kpocza/MachineMeter/docs/Eagle/CircoController.sch

## EAGLE design docs/Eagle/CircoController.sch (2020-05-09)

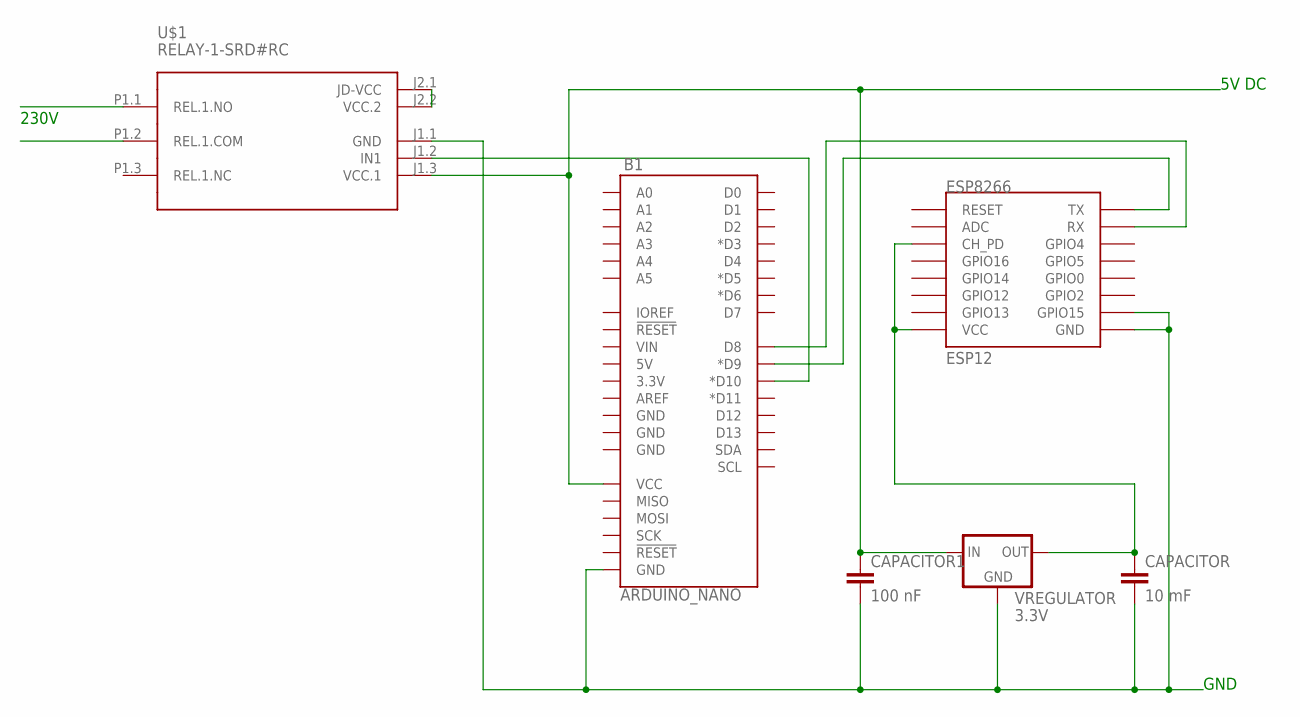
[picture p46: schematic CircoController.sch]

Parts:
B1: ARDUINO_NANO; ARDUINO_R3
CAPACITOR: 10 mF; RESC0201_L
CAPACITOR1: 100 nF; RESC0201_L
ESP8266: ESP12
U$1: RELAY-1-SRD#RC
VREGULATOR: 3.3V; 78LXX

Connections:
unnamed: B1.D9 (*D9), ESP8266.TX
unnamed: B1.D8, ESP8266.RX
unnamed: U$1.J2.1 (JD-VCC), U$1.J2.2 (VCC.2)
unnamed: B1.D10 (*D10), U$1.J1.2 (IN1)
unnamed: B1.GND@1 (GND), CAPACITOR.2, CAPACITOR1.2, ESP8266.GND, ESP8266.GPIO15, U$1.J1.1 (GND), VREGULATOR.GND
unnamed: B1.VCC, CAPACITOR1.1, U$1.J1.3 (VCC.1), VREGULATOR.IN
unnamed: CAPACITOR.1, ESP8266.CH_PD, ESP8266.VCC, VREGULATOR.OUT

Notes on the sheet:
5V DC
GND
230V
