kpocza/MachineMeter/docs/Eagle/CurrentMeter2.sch

## EAGLE design docs/Eagle/CurrentMeter2.sch (2019-06-23)

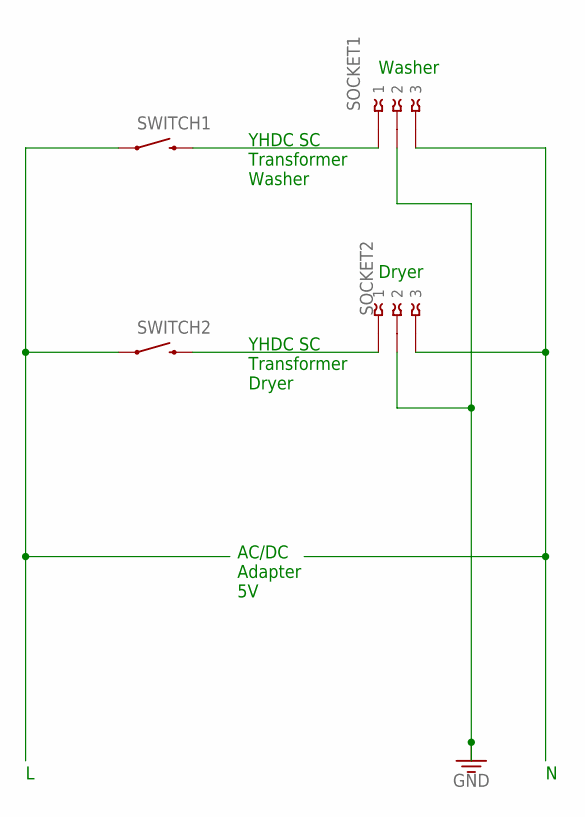
[picture p47: schematic CurrentMeter2.sch]

Parts:
SOCKET1, SOCKET2: 009175003
SWITCH1, SWITCH2: RS032G05A3SM-SPST-MOMENTARY-SWSMD-1101NE; TACTILE-SWITCH-1101NE

Connections:
3.3V: SOCKET1.2@1 (2), SOCKET2.2@1 (2)
unnamed: SWITCH1.1, SWITCH2.1
unnamed: SOCKET1.1@1 (1), SWITCH1.2
unnamed: SOCKET2.1@1 (1), SWITCH2.2
unnamed: SOCKET1.3@2 (3), SOCKET2.3@2 (3)

Notes on the sheet:
AC/DC Adapter 5V
YHDC SC Transformer Washer
YHDC SC Transformer Dryer
Washer
Dryer
