kpocza/MachineMeter/docs/Eagle/CurrentMeter.sch

## EAGLE design docs/Eagle/CurrentMeter.sch (2020-05-09)

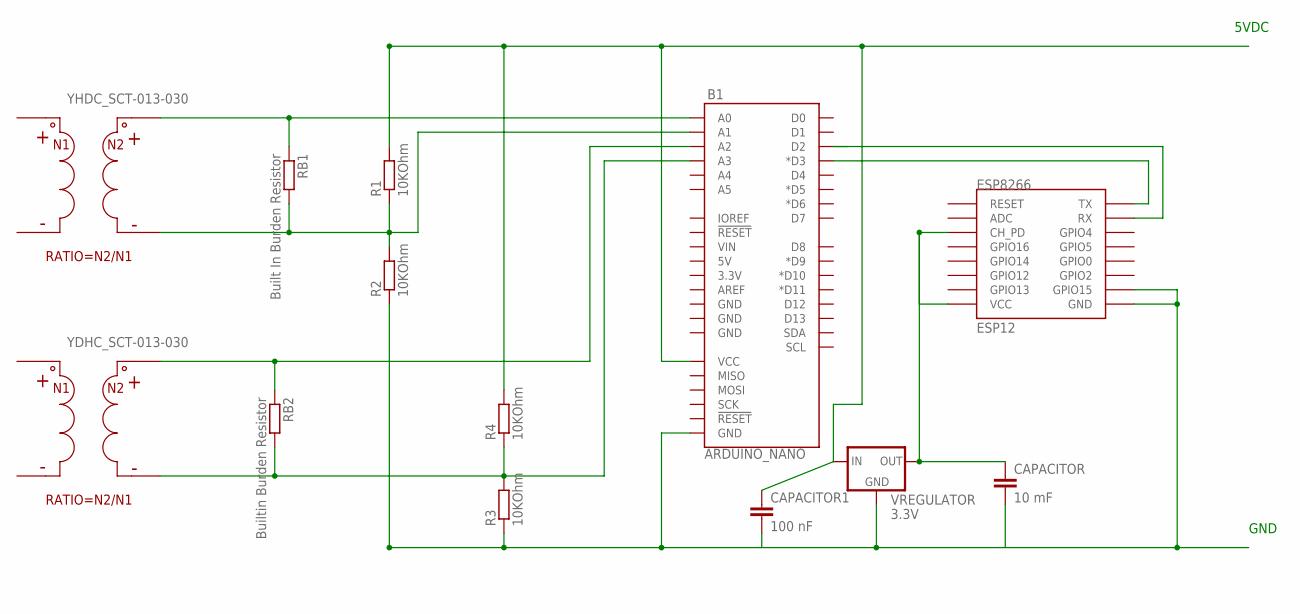
[picture p48: schematic CurrentMeter.sch]

Parts:
B1: ARDUINO_NANO; ARDUINO_R3
CAPACITOR: 10 mF; RESC0201_L
CAPACITOR1: 100 nF; RESC0201_L
ESP8266: ESP12
R1, R2, R3, R4: 10KOhm; R0805
RB1: Built In Burden Resistor; R0805
RB2: Builtin Burden Resistor; R0805
VREGULATOR: 3.3V; 78LXX

Connections:
ESP8266: B1.D3 (*D3), ESP8266.TX
unnamed: B1.A0, RB1.1
unnamed: B1.A1, R1.1, R2.2, RB1.2
unnamed: B1.VCC, CAPACITOR1.1, R1.2, R4.2, VREGULATOR.IN
unnamed: B1.GND@1 (GND), ESP8266.GND, ESP8266.GPIO15, R2.1, R3.1, VREGULATOR.GND
unnamed: B1.A3, R3.2, R4.1, RB2.2
unnamed: B1.A2, RB2.1
unnamed: CAPACITOR.1, ESP8266.CH_PD, ESP8266.VCC, VREGULATOR.OUT
unnamed: B1.D2, ESP8266.RX

Notes on the sheet:
5VDC
GND
