kpocza/MachineMeter/docs/Eagle/InfoDashboardWithCircoSwitch.sch

## EAGLE design docs/Eagle/InfoDashboardWithCircoSwitch.sch (2020-05-09)

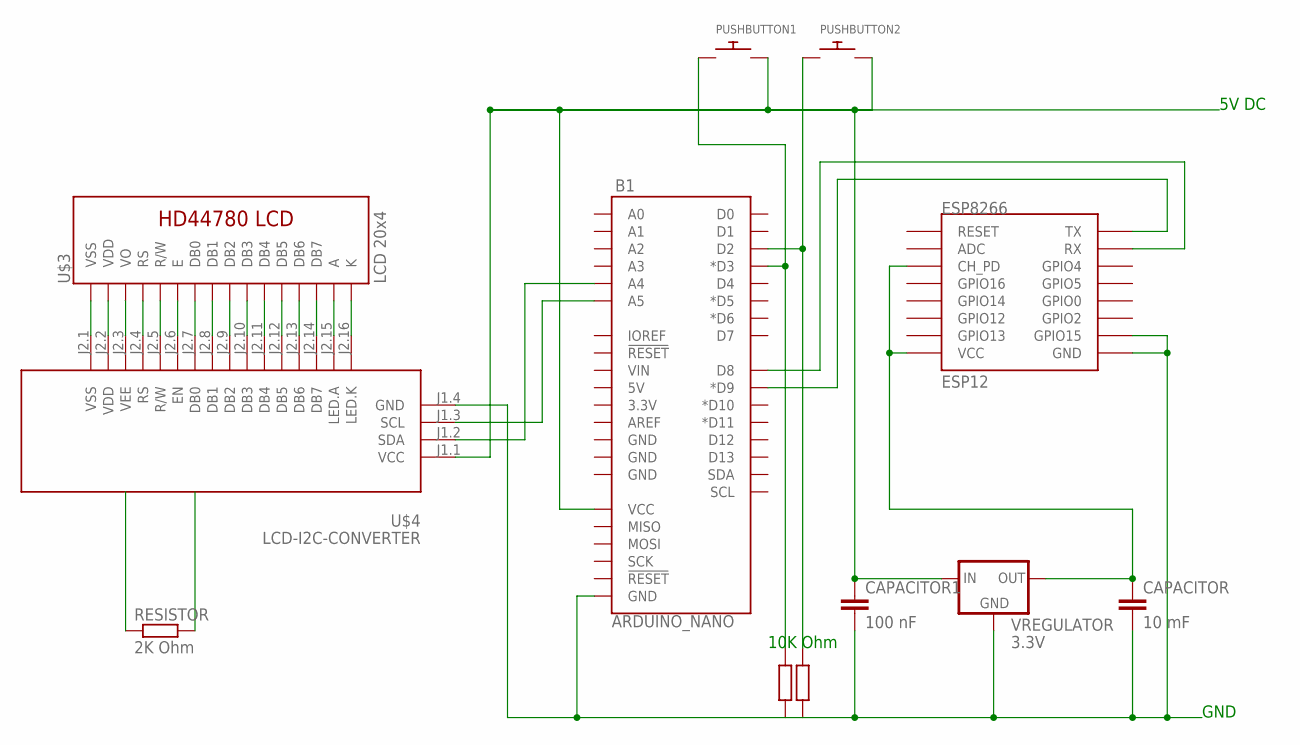
[picture p50: schematic InfoDashboardWithCircoSwitch.sch]

Parts:
B1: ARDUINO_NANO; ARDUINO_R3
CAPACITOR: 10 mF; RESC0201_L
CAPACITOR1: 100 nF; RESC0201_L
ESP8266: ESP12
PUSHBUTTON1, PUSHBUTTON2: SWITCH_PUSHBUTTONC&K_KSS; BTN_CK_KSS
RESISTOR: 2K Ohm; R0805
U$3: LCD 20x4; LCD-16X2-4HOLES-BL
U$4: LCD-I2C-CONVERTER
VREGULATOR: 3.3V; 78LXX

Connections:
unnamed: B1.D9 (*D9), ESP8266.TX
unnamed: U$3.1 (VSS), U$4.J2.1 (VSS)
unnamed: U$3.2 (VDD), U$4.J2.2 (VDD)
unnamed: U$3.3 (VO), U$4.J2.3 (VEE)
unnamed: U$3.4 (RS), U$4.J2.4 (RS)
unnamed: U$3.5 (R/W), U$4.J2.5 (R/W)
unnamed: U$3.6 (E), U$4.J2.6 (EN)
unnamed: U$3.7 (DB0), U$4.J2.7 (DB0)
unnamed: U$3.8 (DB1), U$4.J2.8 (DB1)
unnamed: U$3.9 (DB2), U$4.J2.9 (DB2)
unnamed: U$3.10 (DB3), U$4.J2.10 (DB3)
unnamed: U$3.11 (DB4), U$4.J2.11 (DB4)
unnamed: U$3.12 (DB5), U$4.J2.12 (DB5)
unnamed: U$3.13 (DB6), U$4.J2.13 (DB6)
unnamed: U$3.14 (DB7), U$4.J2.14 (DB7)
unnamed: U$3.15 (A), U$4.J2.15 (LED.A)
unnamed: U$3.16 (K), U$4.J2.16 (LED.K)
unnamed: B1.A4, U$4.J1.2 (SDA)
unnamed: B1.GND@1 (GND), CAPACITOR.2, CAPACITOR1.2, ESP8266.GND, ESP8266.GPIO15, U$4.J1.4 (GND), VREGULATOR.GND
unnamed: B1.D8, B1.VCC, CAPACITOR1.1, ESP8266.RX, PUSHBUTTON1.P$2, PUSHBUTTON2.P$2, U$4.J1.1 (VCC), VREGULATOR.IN
unnamed: CAPACITOR.1, ESP8266.CH_PD, ESP8266.VCC, VREGULATOR.OUT
unnamed: B1.A5, U$4.J1.3 (SCL)
unnamed: B1.D2, PUSHBUTTON2.P$1
unnamed: B1.D3 (*D3), PUSHBUTTON1.P$1

Notes on the sheet:
5V DC
GND
10K Ohm
