kpocza/MachineMeter/(commit log)

2019-01-16 input pin fix, change server IP to bananapi
    [CurrentMeter.ino]
2019-01-22 Info dashboard, fixes, configs
    [CurrentMeter.ino, InfoDashboard.ino]
2019-01-29 Noise reduction of measurement
    [CurrentMeter.ino, DiffEmonLib.cpp, DiffEmonLib.h, InfoDashboard.ino]
2019-02-02 Info dashboard wireing
2019-03-11 More detailed error reporting
    [InfoDashboard.ino]
2019-03-14 Raspberry Pi-ify
2019-04-12 LCD I2C wiring and driving + memory optimizations
2019-06-17 docs material
    [CurrentMeter.sch, InfoDashboard.sch]
2019-06-23 schematics finalized
    [CurrentMeter.sch, CurrentMeter2.sch, InfoDashboard.sch]
2019-11-27 Current meter schematic fix
    [CurrentMeter.sch]
2020-05-09 Documenting warm water pump
    [CircoController.sch, CurrentMeter.sch, InfoDashboardWithCircoSwitch.sch]
